Jellyyz/Floyd-Steinberg-Dithering-Hardware-Accelerator/README.md

# ECE445 Spring 2023, Team 29: Portable Thermal Printer

https://www.youtube.com/watch?v=ZJqiJV0miBM

Printer Video (https://www.youtube.com/watch?v=ZJqiJV0miBM)
