Jellyyz/Floyd-Steinberg-Dithering-Hardware-Accelerator/Proposal/Screenshot 2023-04-26 001853.png

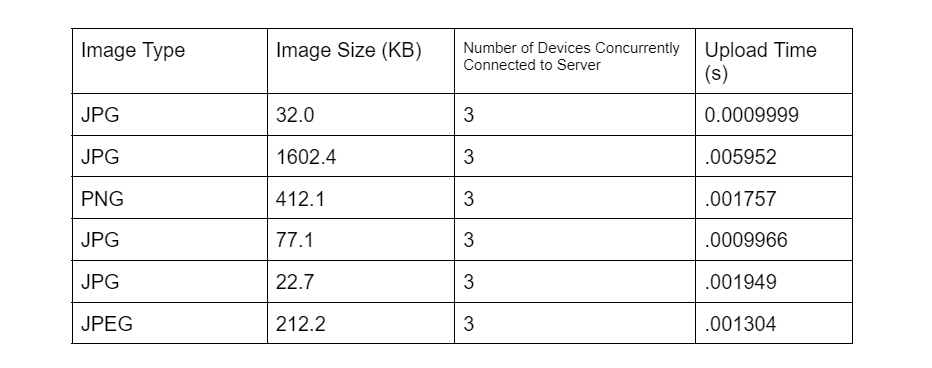
Proposal/Screenshot 2023-04-26 001853.png
