Jellyyz/Floyd-Steinberg-Dithering-Hardware-Accelerator/SPI Test1/MCU/MCU Setup.txt

Follow:
	https://protosupplies.com/product/esp8266-d1-mini-v2-esp-12f-wifi-module/
