Jellyyz/Floyd-Steinberg-Dithering-Hardware-Accelerator/print_master/Probably_0_255_512.png

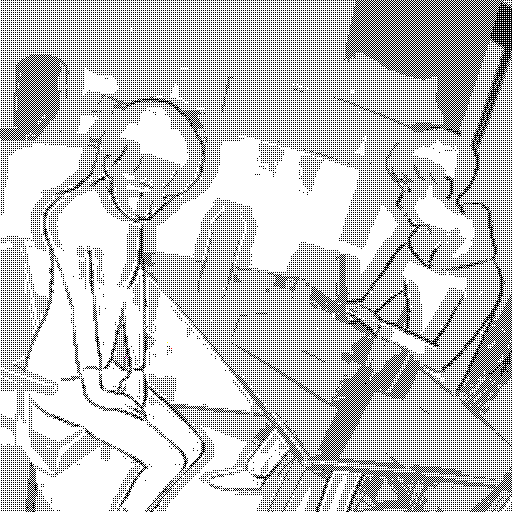
print_master/Probably_0_255_512.png
