Jellyyz/Floyd-Steinberg-Dithering-Hardware-Accelerator/SPI Test1/README.md

Connect the 4 pins for SPI on MCU to FPGA Arduino IO pins (check documentation).
