Jellyyz/Floyd-Steinberg-Dithering-Hardware-Accelerator/SPI Test1/MCU/README.md

Follow:
	https://protosupplies.com/product/esp8266-d1-mini-v2-esp-12f-wifi-module/
if first time setting up ESP-12F.
