Jellyyz/Floyd-Steinberg-Dithering-Hardware-Accelerator/Software Implementation (Non-MCU)/test_after_CLAMP.png

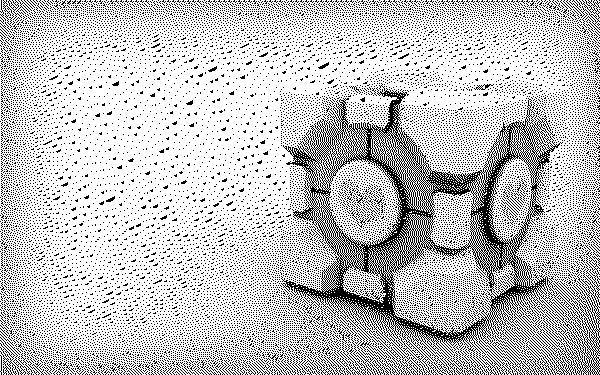
Software Implementation (Non-MCU)/test_after_CLAMP.png
