Jellyyz/Floyd-Steinberg-Dithering-Hardware-Accelerator/Software Implementation (Non-MCU)/test_b4.png

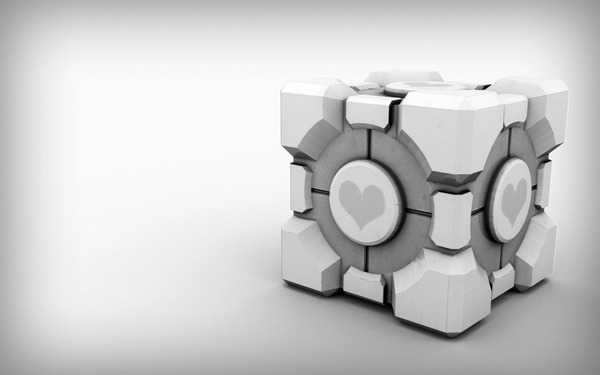
Software Implementation (Non-MCU)/test_b4.png
