Jellyyz/Floyd-Steinberg-Dithering-Hardware-Accelerator/testUpload/uploadSite/media/images/to_be_dithered/949070B2-4E2D-4FB8-AF5E-C3660D196853.jpeg

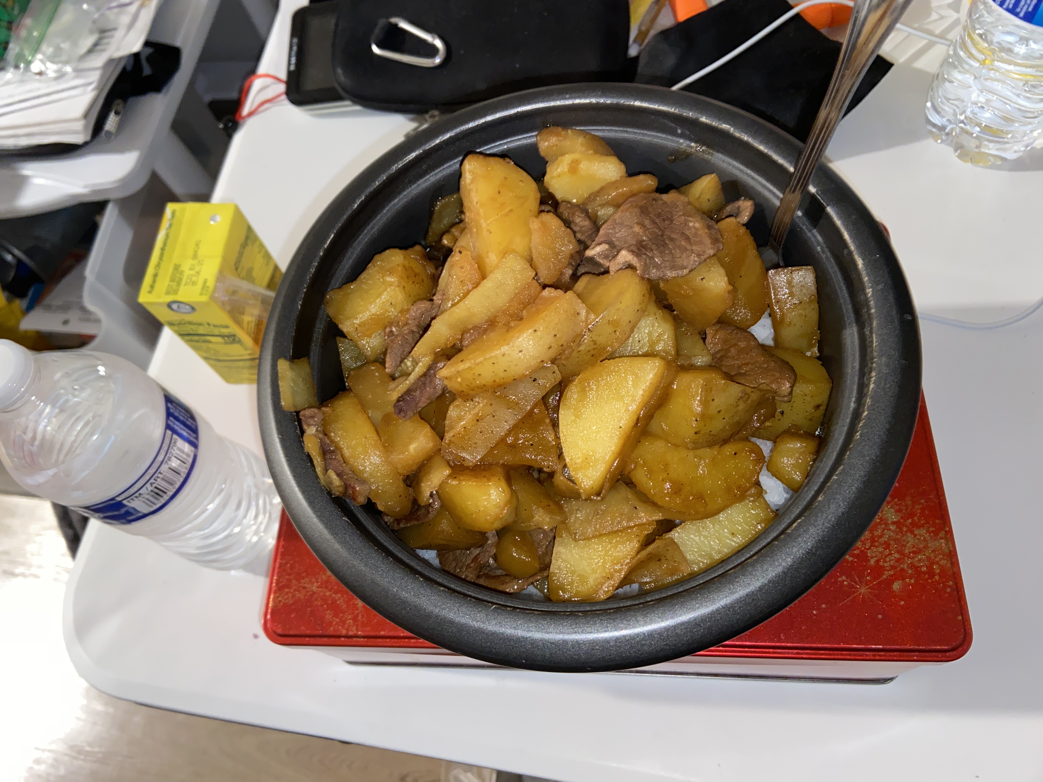
testUpload/uploadSite/media/images/to_be_dithered/949070B2-4E2D-4FB8-AF5E-C3660D196853.jpeg
