Jellyyz/Floyd-Steinberg-Dithering-Hardware-Accelerator/testUpload/uploadSite/media/images/to_be_dithered/D92D2692-BBC4-4815-95E2-C9962D794AF6.jpeg

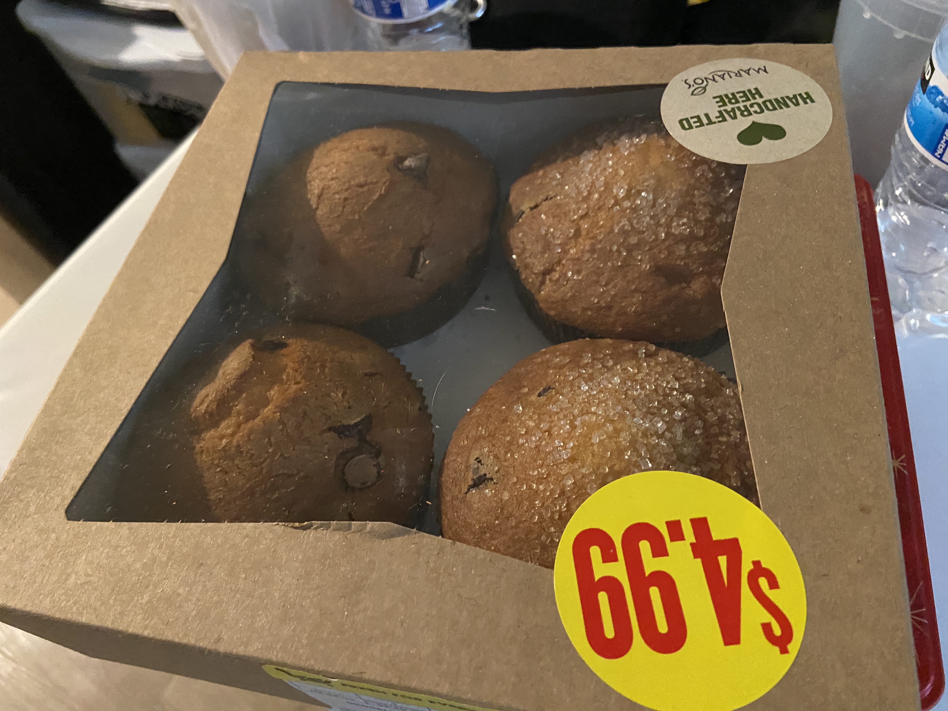
testUpload/uploadSite/media/images/to_be_dithered/D92D2692-BBC4-4815-95E2-C9962D794AF6.jpeg
