Jellyyz/Floyd-Steinberg-Dithering-Hardware-Accelerator/PCB/445_PD/445_PD.kicad_pcb

## KiCad design PCB/445_PD/445_PD.kicad_pcb (2023-05-21)

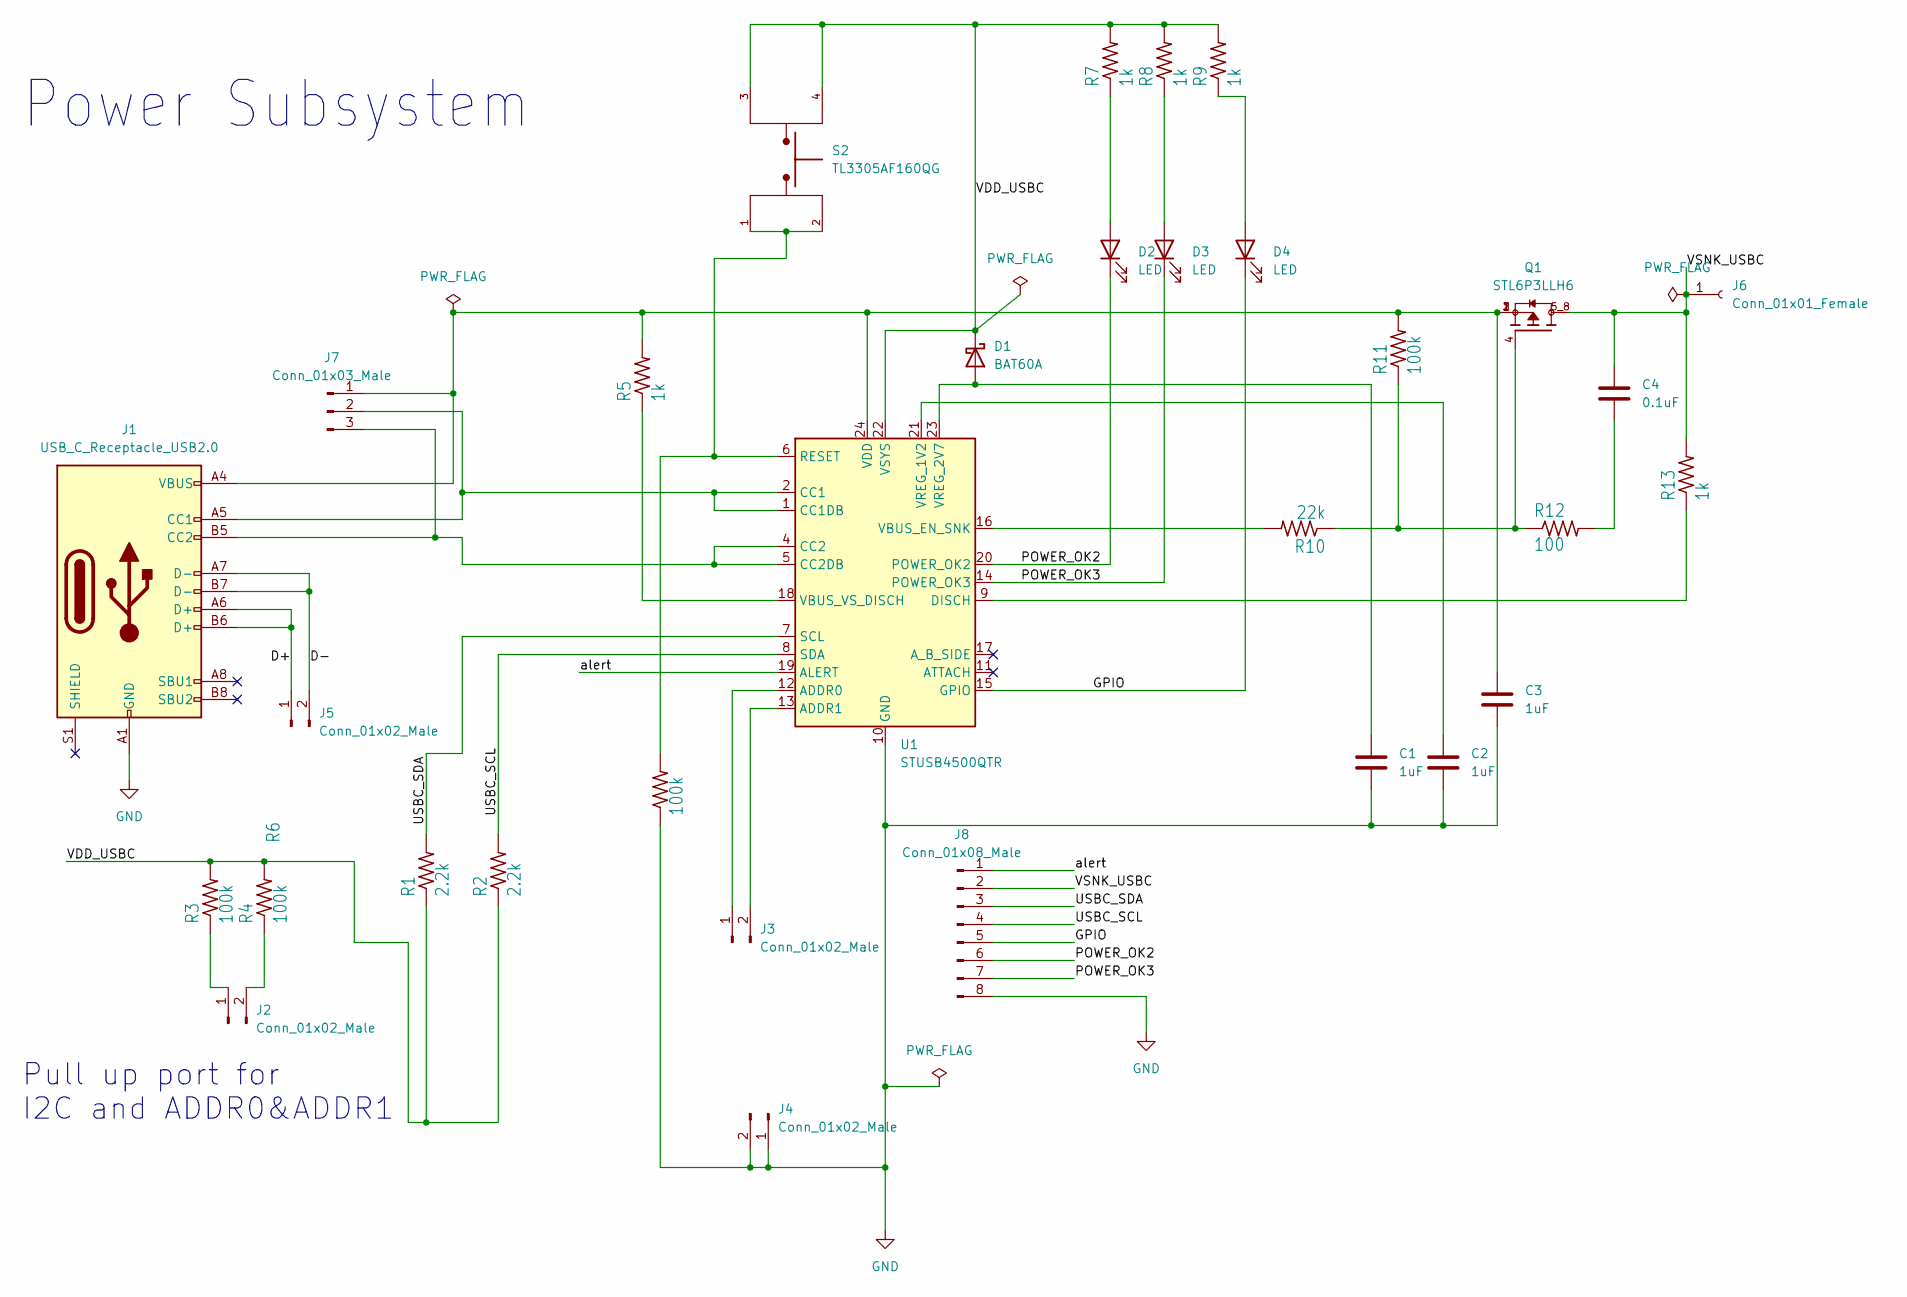
[picture p48: schematic 445_PD.kicad_sch]

Parts:
C1, C2, C3: 1uF; C_0805_2012Metric_Pad1.18x1.45mm_HandSolder
C4: 0.1uF; C_0805_2012Metric_Pad1.18x1.45mm_HandSolder
D1: BAT60A; D_SOD-323
D2, D3, D4: LED; LED_0603_1608Metric_Pad1.05x0.95mm_HandSolder
J1: USB_C_Receptacle_USB2.0; USB_C_Receptacle_GCT_USB4105-xx-A_16P_TopMnt_Horizontal
J2, J3, J4, J5: Conn_01x02_Male; PinHeader_1x02_P2.54mm_Vertical
J6: Conn_01x01_Female; PinHeader_1x01_P2.54mm_Vertical
J7: Conn_01x03_Male; PinHeader_1x03_P2.54mm_Vertical
J8: Conn_01x08_Male; PinHeader_1x08_P2.54mm_Vertical
Q1: STL6P3LLH6; TRANS_STL6P3LLH6; PARTREV 4
R1, R2: 2.2k; R_0805_2012Metric_Pad1.20x1.40mm_HandSolder
R3, R4, R6, R11: 100k; R_0805_2012Metric_Pad1.20x1.40mm_HandSolder
R5, R7, R8, R9, R13: 1k; R_0805_2012Metric_Pad1.20x1.40mm_HandSolder
R10: 22k; R_0805_2012Metric_Pad1.20x1.40mm_HandSolder
R12: 100; R_0805_2012Metric_Pad1.20x1.40mm_HandSolder
S2: TL3305AF160QG; SW_TL3305AF160QG; PARTREV C
U1: STUSB4500QTR; QFN-24-1EP_4x4mm_P0.5mm_EP2.7x2.7mm

Connections:
/D+: J1.A6 (D+), J1.B6 (D+), J5.1
/D-: J1.A7 (D-), J1.B7 (D-), J5.2
/GPIO: D4.1 (K), J8.5, U1.15 (GPIO)
/POWER_OK2: D2.1 (K), J8.6, U1.20 (POWER_OK2)
/POWER_OK3: D3.1 (K), J8.7, U1.14 (POWER_OK3)
/USBC_SCL: J8.4, R2.2, U1.8 (SDA)
/USBC_SDA: J8.3, R1.2, U1.7 (SCL)
/VDD_USBC: D1.1 (K), R1.1, R2.1, R3.2, R4.2, R7.2, R8.2, R9.2, S2.3, S2.4, U1.22 (VSYS)
/VSNK_USBC: C4.1, J6.1, J8.2, Q1.5_8, R13.2
/alert: J8.1, U1.19 (ALERT)
GND: C1.2, C2.2, C3.2, J1.A1 (GND), J1.A12 (GND), J1.B1 (GND), J1.B12 (GND), J4.1, J4.2, J8.8, R6.1, U1.10 (GND), U1.25 (GND)
unnamed: C1.1, D1.2 (A), U1.23 (VREG_2V7)
unnamed: C2.1, U1.21 (VREG_1V2)
unnamed: C3.1, J1.A4 (VBUS), J1.A9 (VBUS), J1.B4 (VBUS), J1.B9 (VBUS), J7.1, Q1.1, Q1.2, Q1.3, R5.2, R11.2, U1.24 (VDD)
unnamed: C4.2, R12.2
unnamed: D2.2 (A), R7.1
unnamed: D3.2 (A), R8.1
unnamed: D4.2 (A), R9.1
unnamed: J1.A5 (CC1), J7.2, U1.1 (CC1DB), U1.2 (CC1)
unnamed: J1.B5 (CC2), J7.3, U1.4 (CC2), U1.5 (CC2DB)
unnamed: J2.1, R3.1
unnamed: J2.2, R4.1
unnamed: J3.1, U1.12 (ADDR0)
unnamed: J3.2, U1.13 (ADDR1)
unnamed: Q1.4, R10.1, R11.1, R12.1
unnamed: R5.1, U1.18 (VBUS_VS_DISCH)
unnamed: R6.2, S2.1, S2.2, U1.6 (RESET)
unnamed: R10.2, U1.16 (VBUS_EN_SNK)
unnamed: R13.1, U1.9 (DISCH)

Notes on the sheet:
Power Subsystem
Pull up port for I2C and ADDR0&ADDR1

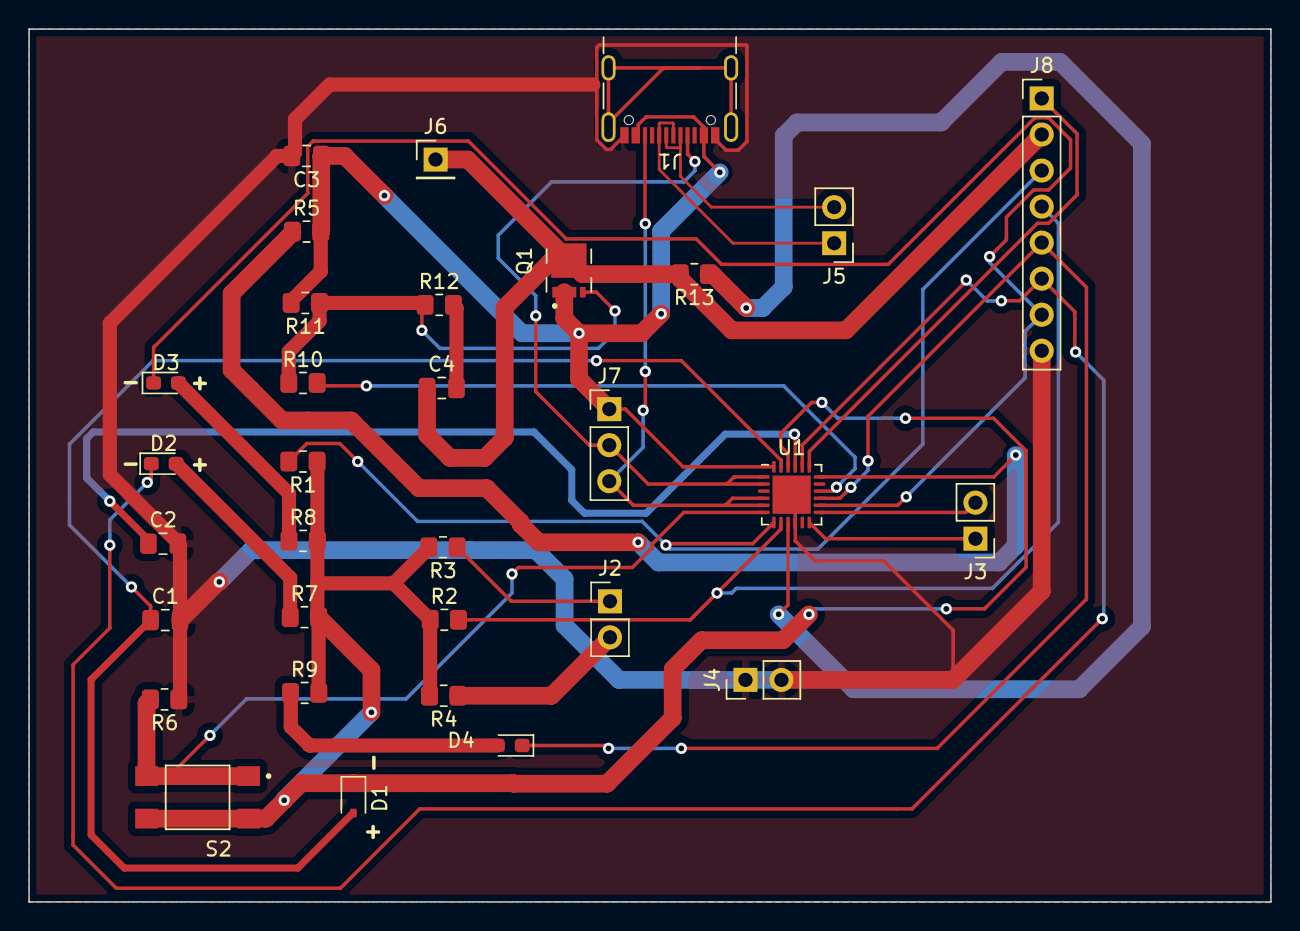
[picture p49: board 445_PD.kicad_pcb from above]

Board: 2 copper layers, 87.5 x 61.5 mm, 32 parts (0 on the bottom side), 29 nets.
