Jellyyz/Floyd-Steinberg-Dithering-Hardware-Accelerator/PCB/445_MCU_pcb.kicad_pcb

## KiCad design PCB/445_MCU_pcb.kicad_pcb (2023-05-21)

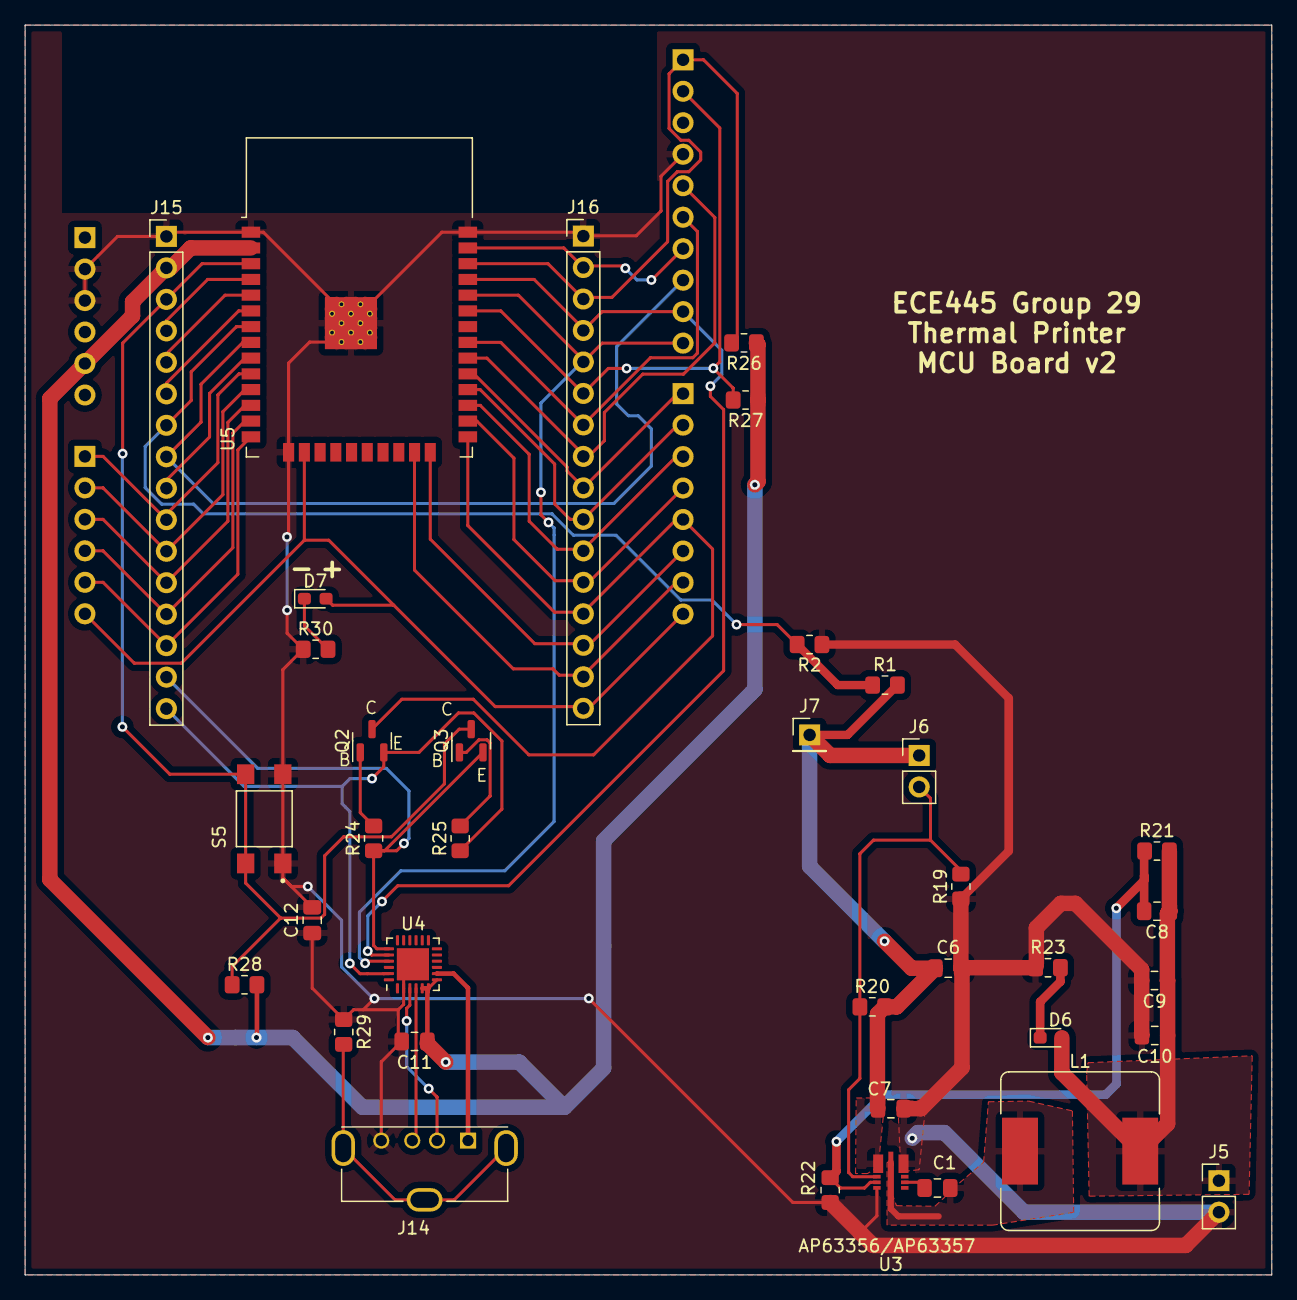
[picture p50: board 445_MCU_pcb.kicad_pcb from above]

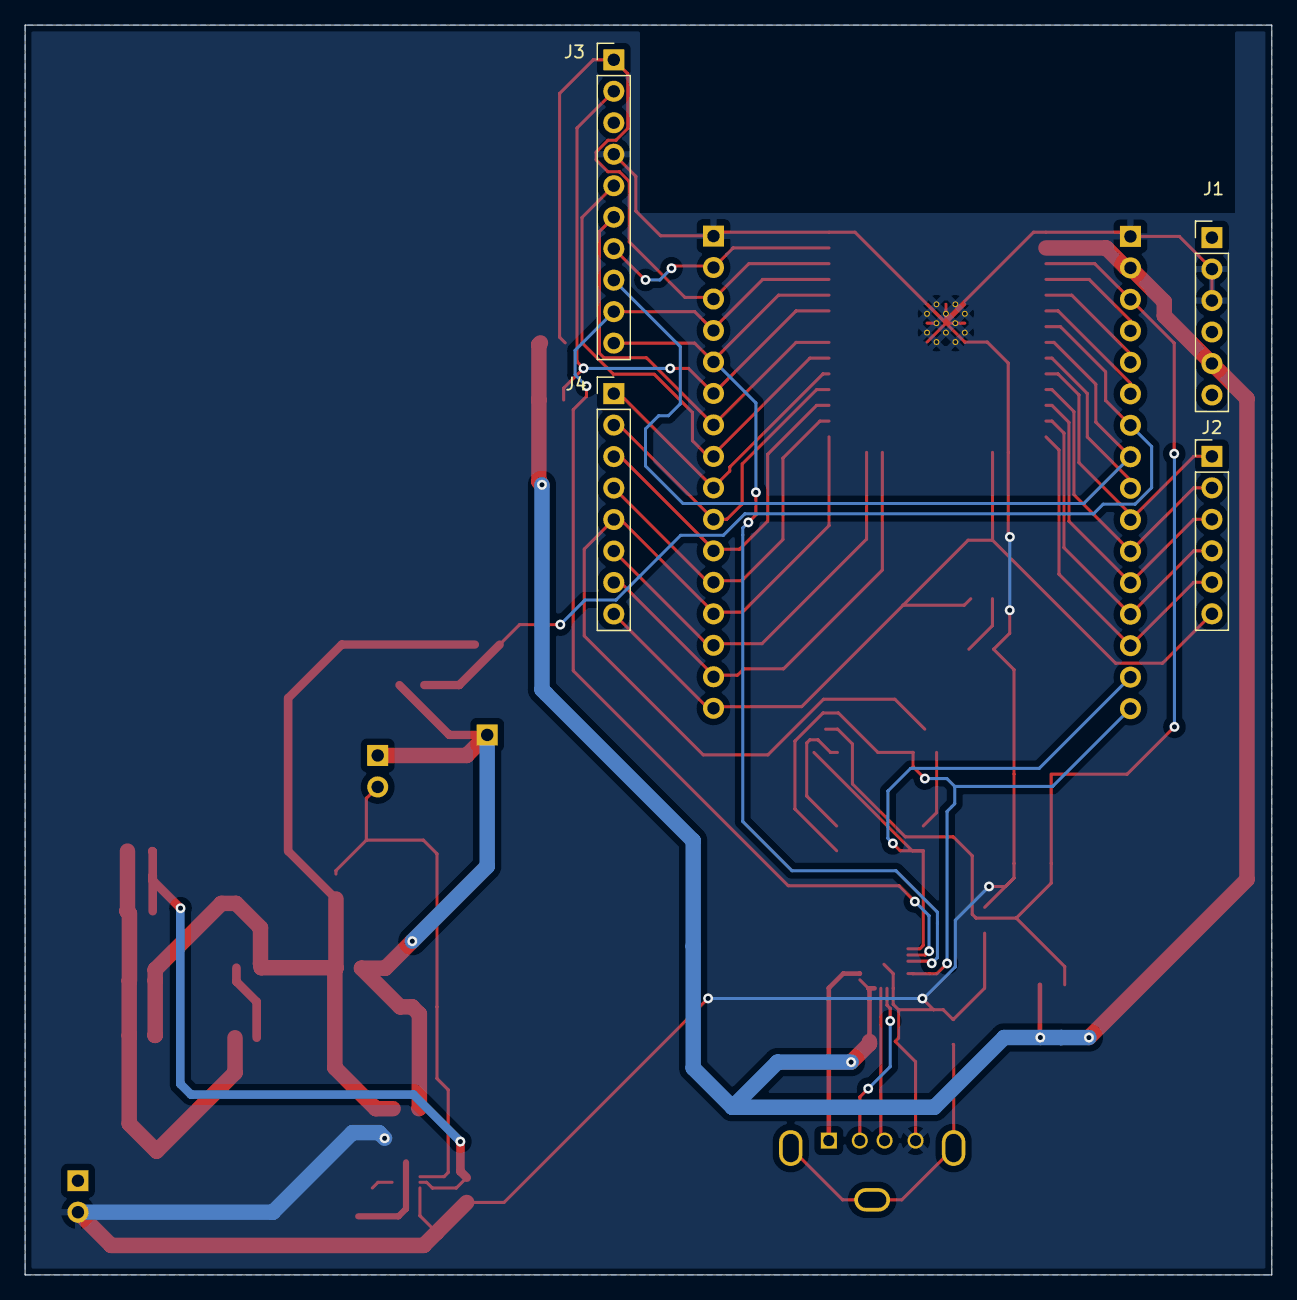
[picture p51: board 445_MCU_pcb.kicad_pcb from below]

Board: 2 copper layers, 100.6 x 100.8 mm, 41 parts (4 on the bottom side), 45 nets.

Parts:
C1: 0.1uF; C_0805_2012Metric_Pad1.18x1.45mm_HandSolder
C6, C7, C12: 4.7uF; C_0805_2012Metric_Pad1.18x1.45mm_HandSolder
C8: 47pF; C_0805_2012Metric_Pad1.18x1.45mm_HandSolder
C9, C10: 22uF; C_0805_2012Metric_Pad1.18x1.45mm_HandSolder
C11: 10uF; C_0805_2012Metric_Pad1.18x1.45mm_HandSolder
D6, D7: LED; LED_0603_1608Metric_Pad1.05x0.95mm_HandSolder
J1, J2: Conn_01x06_Male; PinHeader_1x06_P2.54mm_Vertical
J3: Conn_01x10_Male; PinHeader_1x10_P2.54mm_Vertical
J4: Conn_01x08_Male; PinHeader_1x08_P2.54mm_Vertical
J5, J6: Conn_01x02_Male; PinHeader_1x02_P2.54mm_Vertical
J7: Conn_01x01_Female; PinHeader_1x01_P2.54mm_Vertical
J14: USB_A; USB_A_Molex_105057_Vertical
J15, J16: Conn_01x16_Female; PinHeader_1x16_P2.54mm_Vertical
L1: 6.8uH; L_Bourns_SRR1260
Q2, Q3: MMBT5550L; SOT-23
R1, R2, R29: 100k; R_0805_2012Metric_Pad1.20x1.40mm_HandSolder
R19: 22k; R_0805_2012Metric_Pad1.20x1.40mm_HandSolder
R20: 93.1k; R_0805_2012Metric_Pad1.20x1.40mm_HandSolder
R21: 220k; R_0805_2012Metric_Pad1.20x1.40mm_HandSolder
R22: 41.2k; R_0805_2012Metric_Pad1.20x1.40mm_HandSolder
R23, R26, R27: 2.2k; R_0805_2012Metric_Pad1.20x1.40mm_HandSolder
R24, R25, R28: 10k; R_0805_2012Metric_Pad1.20x1.40mm_HandSolder
R30: 1k; R_0805_2012Metric_Pad1.20x1.40mm_HandSolder
S5: TL3305AF160QG; SW_TL3305AF160QG
U3: AP63356/AP63357; AP63357DV-7
U4: CP2104; QFN-24-1EP_4x4mm_P0.5mm_EP2.6x2.6mm
U5: ESP32-WROOM-32

Connections:
3.3V1: C11.1, J1.5, J15.2, R26.1, R27.1, R28.2, U4.5 (VIO), U4.6 (VDD), U4.7 (REGIN), U5.2 (VDD)
/7_4VIn: C6.1, C7.1, J6.1, J7.1, R1.2, R20.2, U3.1 (VIN)
/DTR: J15.16, Q2.2 (E), R25.1, U4.23 (~DTR)
/EN: J6.2, R19.2, R20.1, U3.2 (EN)
/IO0: J4.5, J16.13, Q2.3 (C), U5.25 (IO0)
/IO1/UART0_TX: J3.9, J16.4, U4.20 (RXD), U5.35 (TXD0/IO1)
/IO2: J4.6, J16.14, U5.24 (IO2)
/IO3/UART0_RX: J3.10, J16.5, U4.21 (TXD), U5.34 (RXD0/IO3)
/IO4/A2_C0: J4.4, J16.12, U5.26 (IO4)
/IO5: J4.1, J16.9, U5.29 (IO5)
/IO12/A2_C5: J2.5, J15.14, U5.14 (IO12)
/IO13/A2_C4: D7.2 (A), J2.6, J4.8, J16.16, U5.16 (IO13)
/IO14/A2_C6: J2.4, J15.13, U5.13 (IO14)
/IO15/A2_C3: J4.7, J16.15, U5.23 (IO15)
/IO16/UART2_RX: J4.3, J16.11, U5.27 (IO16)
/IO17/UART2_TX: J4.2, J16.10, U5.28 (IO17)
/IO18/SCLK: J3.5, J16.8, U5.30 (IO18)
/IO19/MISO: J3.6, J16.7, U5.31 (IO19)
/IO21/SDA: J3.2, J16.6, R27.2, U5.33 (IO21)
/IO22/SCL: J3.1, J16.3, R26.2, U5.36 (IO22)
/IO23/MOSI: J3.7, J16.2, U5.37 (IO23)
/IO25/A2_C8: J2.1, J15.10, U5.10 (IO25)
/IO26/A2_c9: J2.2, J15.11, U5.11 (IO26)
/IO27/A2_C7: J2.3, J15.12, U5.12 (IO27)
/IO32/SPI_SS: J3.8, J15.8, U5.8 (IO32)
/IO33/SPI_CLK: J15.9, U5.9 (IO33)
/IO34/IN_ONLY: J15.6, U5.6 (IO34)
/IO35/IN_ONLY: J15.7, R1.1, R2.2, U5.7 (IO35)
/RST: J15.3, Q3.3 (C), R28.1, S5.3, S5.4, U5.3 (EN)
/RTS: J15.15, Q3.2 (E), R24.1, U4.19 (~RTS)
/SENSOR_VN/IO39: J15.5, U5.5 (SENSOR_VN)
/SENSOR_VP/IO36: J15.4, U5.4 (SENSOR_VP)
GND: C6.2, C7.2, C9.2, C10.2, C11.2, C12.1, C12.2, J1.2, J1.3, J3.4, J5.2, J14.4 (GND), J15.1, J16.1, R2.1, R19.1, R22.1, R23.1, R29.1, R30.1, S5.1, S5.2, U3.4 (COMP), U3.8 (GND), U4.2 (GND), U4.25 (GND), U5.1 (GND), U5.15 (GND), U5.38 (GND), U5.39 (GND)
unnamed: C1.1, U3.6 (BST)
unnamed: C1.2, L1.1, U3.9 (SW)
unnamed: C8.2, R21.1, R22.2, U3.3 (FB)
unnamed: D6.1 (K), R23.2
unnamed: D7.1 (K), R30.2
unnamed: J14.1 (VBUS), U4.8 (VBUS)
unnamed: J14.2 (D-), U4.3 (D+)
unnamed: J14.3 (D+), U4.4 (D-)
unnamed: J14.5 (Shield), R29.2
unnamed: Q2.1 (B), R24.2
unnamed: Q3.1 (B), R25.2
TO_FPGA_USB: C8.1, C9.1, C10.1, D6.2 (A), J5.1, L1.2, R21.2
