Jellyyz/Floyd-Steinberg-Dithering-Hardware-Accelerator/PCB/445.kicad_pcb

## KiCad design PCB/445.kicad_pcb (2023-03-10)

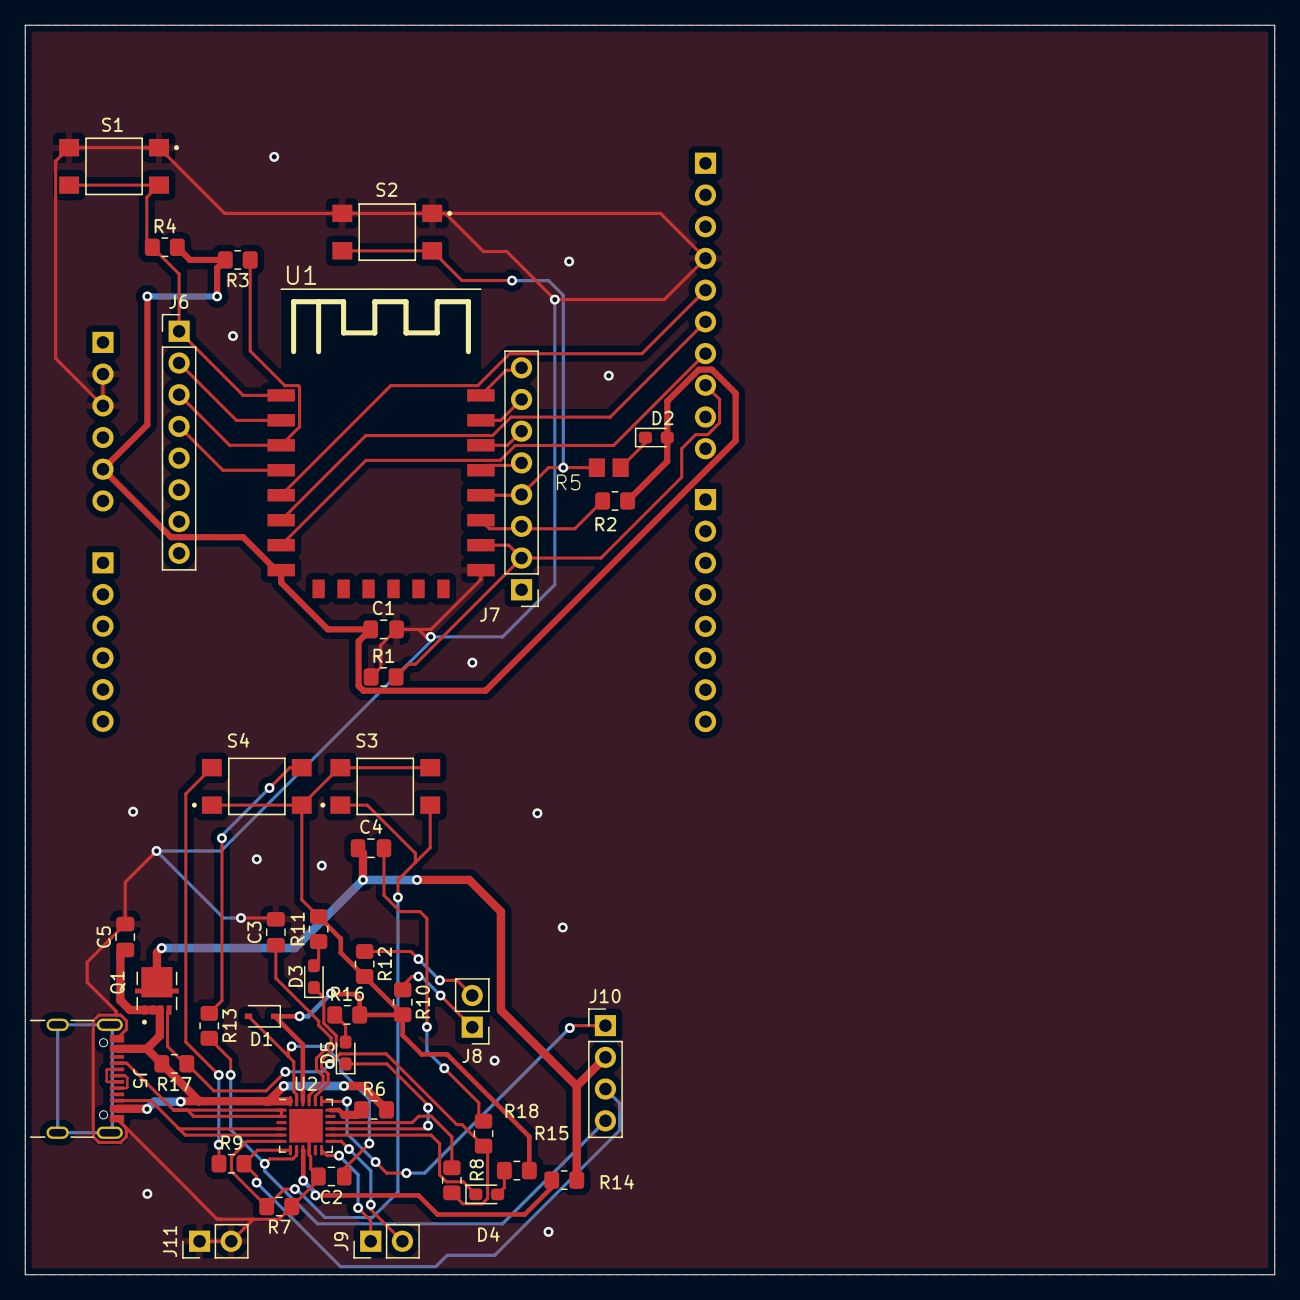
[picture p52: board 445.kicad_pcb from above]

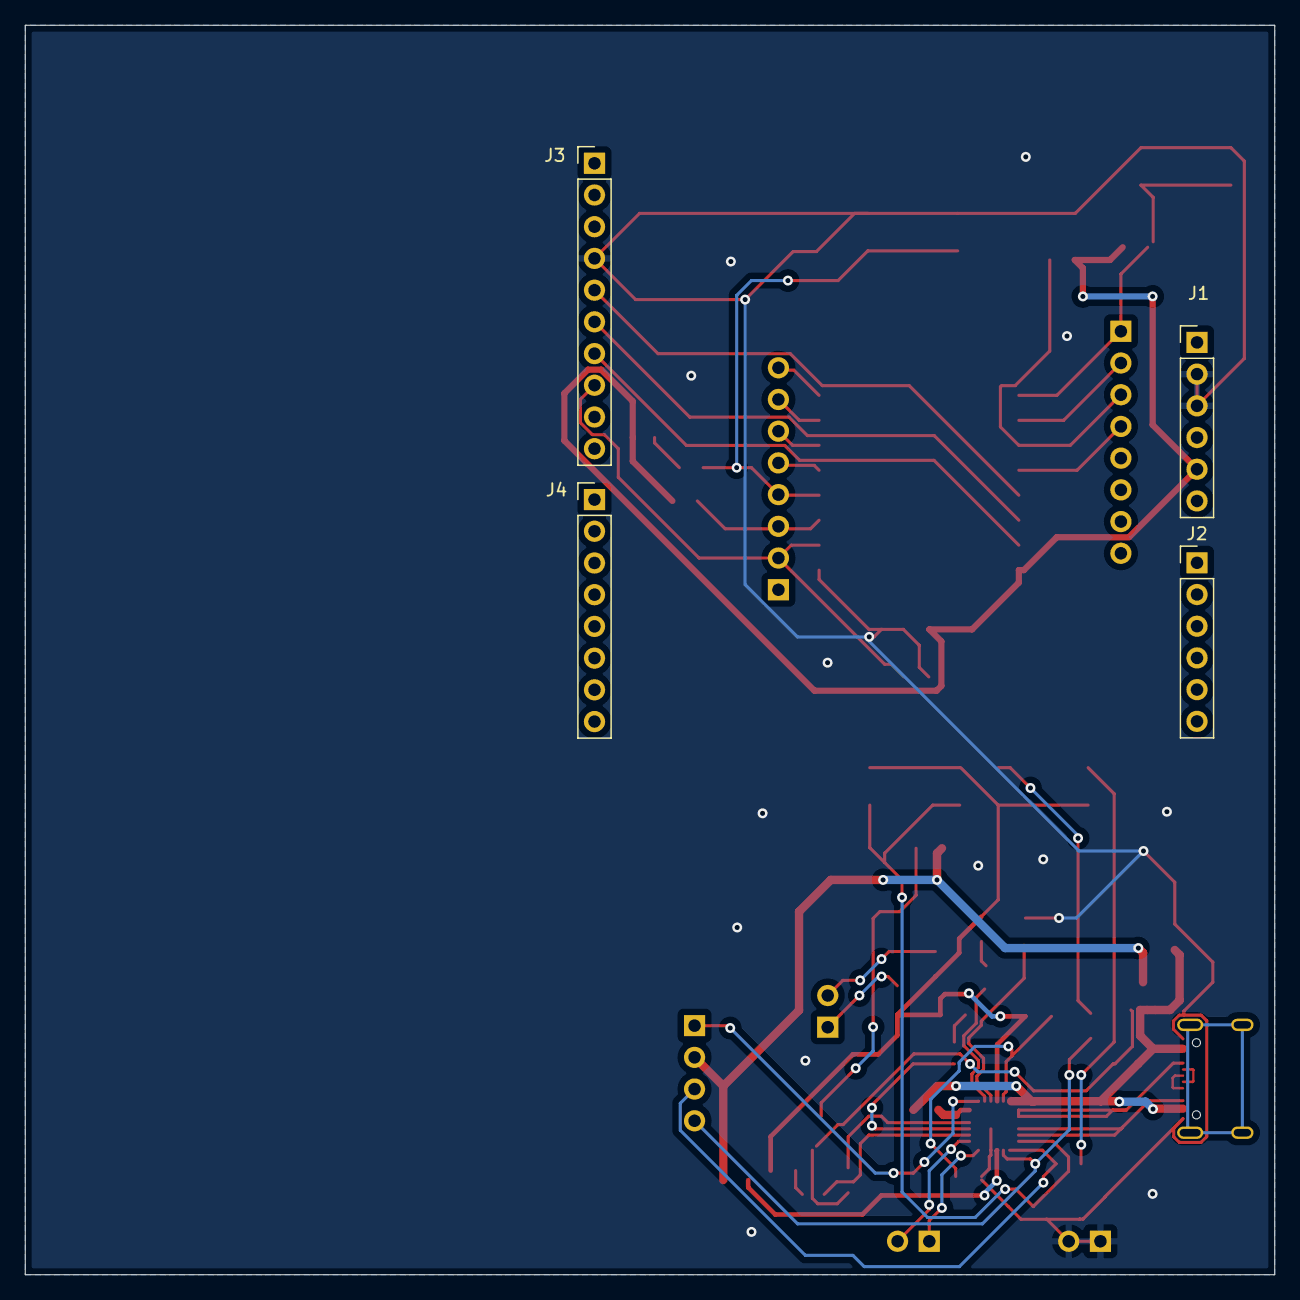
[picture p53: board 445.kicad_pcb from below]

Board: 2 copper layers, 100.1 x 100.1 mm, 46 parts (4 on the bottom side), 47 nets.

Parts:
C1, C2, C3, C5: 1uF; C_0805_2012Metric_Pad1.18x1.45mm_HandSolder
C4: 0.1uF; C_0805_2012Metric_Pad1.18x1.45mm_HandSolder
D1: BAT60A; D_SOD-323
D2, D3, D4, D5: LED; LED_0603_1608Metric_Pad1.05x0.95mm_HandSolder
J1, J2: Conn_01x06_Male; PinHeader_1x06_P2.54mm_Vertical
J3: Conn_01x10_Male; PinHeader_1x10_P2.54mm_Vertical
J4: Conn_01x08_Male; PinHeader_1x08_P2.54mm_Vertical
J5: USB_C_Receptacle_USB2.0; USB_C_Receptacle_GCT_USB4105-xx-A_16P_TopMnt_Horizontal
J6, J7: Conn_01x08_Female; PinHeader_1x08_P2.54mm_Vertical
J8, J9, J11: Conn_01x02_Male; PinHeader_1x02_P2.54mm_Vertical
J10: Conn_01x04_Male; PinHeader_1x04_P2.54mm_Vertical
Q1: STL6P3LLH6; TRANS_STL6P3LLH6
R1, R2, R3, R4: 10k; R_0805_2012Metric_Pad1.20x1.40mm_HandSolder
R5: R-US_R0805; R0805
R6, R11, R14, R15, R16: 1k; R_0805_2012Metric_Pad1.20x1.40mm_HandSolder
R7, R10, R12, R17: 100k; R_0805_2012Metric_Pad1.20x1.40mm_HandSolder
R8: 22k; R_0805_2012Metric_Pad1.20x1.40mm_HandSolder
R9, R13: 2.2k; R_0805_2012Metric_Pad1.20x1.40mm_HandSolder
R18: 100; R_0805_2012Metric_Pad1.20x1.40mm_HandSolder
S1, S2, S3, S4: TL3305AF160QG; SW_TL3305AF160QG
U1: ESP-12F
U2: STUSB4500QTR; QFN-24-1EP_4x4mm_P0.5mm_EP2.7x2.7mm

Connections:
/3.3V1: C1.1, D2.2 (A), J1.5, R2.2, R3.2, R4.2, U1.8 (VCC)
/ADC: J6.2, U1.2 (ADC)
/D+: J5.A6 (D+), J5.B6 (D+)
/D-: J5.A7 (D-), J5.B7 (D-)
/ESP_EN: J6.3, R3.1, U1.3 (CH_PD)
/ESP_RST: J6.1, R4.1, S1.3, S1.4, U1.1 (REST)
/GPIO0: J7.4, R5.1, S2.3, S2.4, U1.18 (GPIO0)
/GPIO4: J7.5, U1.19 (GPIO04)
/GPIO5: J7.6, U1.20 (GPIO05)
/GPIO15/SS: J3.8, J7.2, R1.2, U1.16 (GPIO15)
/GPIO16: J6.4, U1.4 (GPIO16)
/LED_GPIO2_BOOT: J7.3, R2.1, U1.17 (GPIO02)
/MISO: J3.6, U1.6 (GPIO12)
/MOSI: J3.7, U1.7 (GPIO13)
/RX: J7.7, U1.21 (RXD)
/SCLK: J3.5, U1.5 (GPIO14)
/TX: J7.8, U1.22 (TXD)
/USBC_SCL: J10.4, R13.2, U2.8 (SDA)
/USBC_SDA: J10.3, R9.2, U2.7 (SCL)
/VDD_USBC: D1.1 (K), R10.2, R11.2, R12.2, R15.2, R16.2, S3.3, S3.4, S4.1, S4.2, U2.22 (VSYS)
/VSNK_USBC: C4.1, J10.2, Q1.5_8, R14.2
/alert: J10.1, U2.19 (ALERT)
GND: C1.2, C2.2, C3.2, C5.2, J1.2, J1.3, J3.4, J5.A1 (GND), J5.A12 (GND), J5.B1 (GND), J5.B12 (GND), J11.1, J11.2, R1.1, R7.1, S1.1, S1.2, S2.1, S2.2, U1.15 (GND), U2.10 (GND), U2.25 (GND)
unnamed: C2.1, D1.2 (A), U2.23 (VREG_2V7)
unnamed: C3.1, U2.21 (VREG_1V2)
unnamed: C4.2, R18.2
unnamed: C5.1, J5.A4 (VBUS), J5.A9 (VBUS), J5.B4 (VBUS), J5.B9 (VBUS), Q1.1, Q1.2, Q1.3, R6.2, R17.2, U2.24 (VDD)
unnamed: D2.1 (K), R5.2
unnamed: D3.1 (K), U2.20 (POWER_OK2)
unnamed: D3.2 (A), R11.1
unnamed: D4.1 (K), U2.14 (POWER_OK3)
unnamed: D4.2 (A), R15.1
unnamed: D5.1 (K), U2.15 (GPIO)
unnamed: D5.2 (A), R16.1
unnamed: J5.A5 (CC1), U2.1 (CC1DB), U2.2 (CC1)
unnamed: J5.B5 (CC2), U2.4 (CC2), U2.5 (CC2DB)
unnamed: J8.1, R10.1
unnamed: J8.2, R12.1
unnamed: J9.1, U2.12 (ADDR0)
unnamed: J9.2, U2.13 (ADDR1)
unnamed: Q1.4, R8.1, R17.1, R18.1
unnamed: R6.1, U2.18 (VBUS_VS_DISCH)
unnamed: R7.2, S3.1, S3.2, U2.6 (RESET)
unnamed: R8.2, U2.16 (VBUS_EN_SNK)
unnamed: R9.1, S4.3
unnamed: R13.1, S4.4
unnamed: R14.1, U2.9 (DISCH)
