Jellyyz/Floyd-Steinberg-Dithering-Hardware-Accelerator/(commit log)

2023-02-14 Added .sch and etc.
    [_esp8266.kicad_sch]
2023-02-16 Updated schematic
    [_esp8266.kicad_sch]
2023-02-22 add final team contract and some hdl
    [DoodleJump.csv, ECE445Final.smp_dump.txt, Lab5_2.csv]
2023-02-24 Added non-PCB files for MCU breakout board
    [_esp8266.kicad_sch]
2023-03-10 march 9th pushing schematic and v2 proposal
    [445-B_Cu.gbr, 445-B_Mask.gbr, 445-B_Paste.gbr, 445-B_Silkscreen.gbr, 445-Edge_Cuts.gbr, 445-F_Cu.gbr, 445-F_Mask.gbr, 445-F_Paste.gbr]
2023-03-11 Added basic MCU-FPGA SPI test code
2023-03-11 Added compatible C++ implementation... unsure correctness
    [floyd_steinberg.cpp, floyd_steinberg.h, lodepng.cpp, lodepng.h, lodepng_helper.h]
2023-03-13 Updated SPI Test 1 top level to adv.
2023-03-17 testing memory
    [ECE445Final.smp_dump.txt]
2023-04-11 Upload printer page img.
2023-04-12 Upload SPI diagram
2023-04-15 Current build of print-as-is system
2023-04-17 Uploaded print test img from 4/14
2023-04-17 Added untested looping SPI controller
2023-04-22 Variable size looping decent printing (prob.-based GET)
2023-05-02 Publish final versions that's flashed on PCB
2023-05-04 last commit, upload sample of frontend
2023-05-21 final push
    [445-B_Cu.gbr, 445-B_Mask.gbr, 445-B_Paste.gbr, 445-B_Silkscreen.gbr, 445-Edge_Cuts.gbr, 445-F_Cu.gbr, 445-F_Mask.gbr, 445-F_Paste.gbr]
