Jellyyz/Floyd-Steinberg-Dithering-Hardware-Accelerator/(notices)

Notices in the files:
Server2MCU2Server/mcu_upload/b64.cpp:
The Original Code and all software distributed under the License are
parts and their libraries:
Copyright 2021 Accelerated Designs. All rights reserved.
