Jellyyz/Floyd-Steinberg-Dithering-Hardware-Accelerator/testUpload/uploadSite/media/images/to_be_dithered/CE79529D-AE46-4540-835B-4EA0550522B8.jpeg

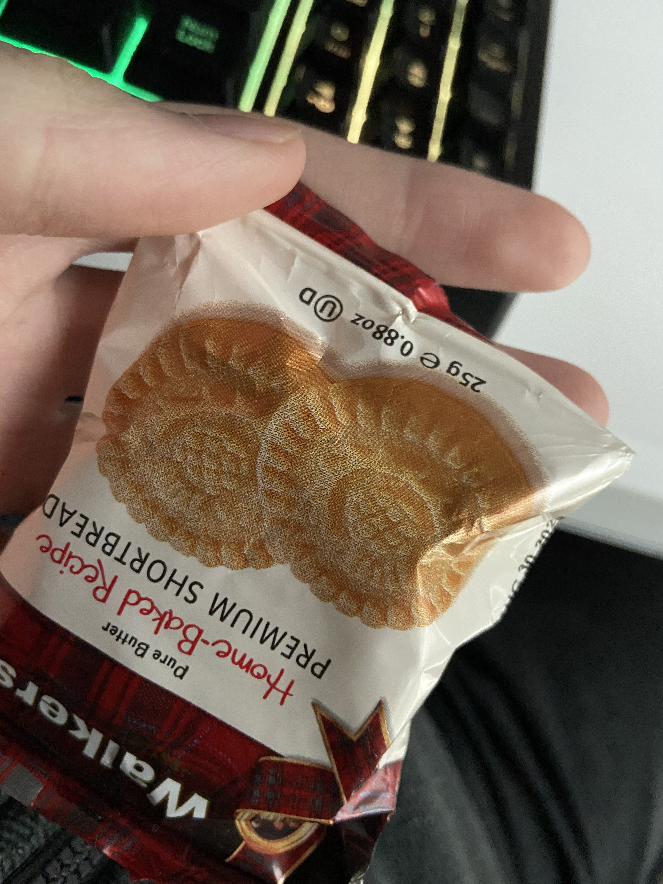
testUpload/uploadSite/media/images/to_be_dithered/CE79529D-AE46-4540-835B-4EA0550522B8.jpeg
